Izziabby/Amp-lified/results/FET_OUTPUT.csv

#Digilent WaveForms Oscilloscope Acquisition
#Device Name: Discovery2NI
#Serial Number: SN:210321ABE20B
#Date Time: 2021-12-18 19:17:53.425
#Sample rate: 5e+06Hz
#Samples: 8192
#Trigger: Source: Channel 1 Type: Pulse Condition: Positive Level: 830 uV LCondition: Less Length: 500 ms Hyst.: 100 mV HoldOff: 100 ns
#Channel 1: Range: 1 V/div Offset: 0 div Attenuation: 1 X
#Channel 2: Range: 1 V/div Offset: -4.4 V Attenuation: 1 X
Time (s) | Channel 1 (V) | Channel 2 (V)
-0.000649902479338843 | -0.03114741341079754 | -0.02074836191465845
-0.000649702479338843 | -0.03488484549735023 | -0.02449063042452249
-0.000649502479338843 | -0.03488484549735023 | -0.02074836191466016
-0.000649302479338843 | -0.03488484549734853 | -0.02449063042452249
-0.0006491024793388431 | -0.03114741341079924 | -0.02449063042452249
-0.0006489024793388431 | -0.02740998132424655 | -0.02823289893438393
-0.0006487024793388431 | -0.02740998132424485 | -0.02449063042452249
-0.0006485024793388431 | -0.03114741341079754 | -0.02823289893438563
-0.000648302479338843 | -0.03114741341079754 | -0.02449063042452249
-0.000648102479338843 | -0.02740998132424485 | -0.02449063042452249
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
