Izziabby/Amp-lified/results/FET_OUTPUT_NO_I.csv

#Digilent WaveForms Oscilloscope Acquisition
#Device Name: Discovery2NI
#Serial Number: SN:210321ABE20B
#Date Time: 2021-12-18 19:20:11.627
#Sample rate: 8.33333e+06Hz
#Samples: 8192
#Trigger: Source: Channel 1 Type: Pulse Condition: Positive Level: 830 uV LCondition: Less Length: 500 ms Hyst.: 100 mV HoldOff: 100 ns
#Channel 1: Range: 1 V/div Offset: 0 div Attenuation: 1 X
#Channel 2: Range: 1 V/div Offset: -4.4 V Attenuation: 1 X
Time (s) | Channel 1 (V) | Channel 2 (V)
-0.0001980487359714862 | -0.3824660295467505 | 3.292613468573211
-0.0001979287359714862 | -0.3824660295467505 | 3.296355737083075
-0.0001978087359714861 | -0.3862034616333014 | 3.292613468573212
-0.0001976887359714862 | -0.3824660295467505 | 3.296355737083075
-0.0001975687359714861 | -0.3862034616333014 | 3.292613468573211
-0.0001974487359714862 | -0.3824660295467522 | 3.292613468573211
-0.0001973287359714862 | -0.3899408937198559 | 3.288871200063348
-0.0001972087359714862 | -0.3862034616333049 | 3.288871200063348
-0.0001970887359714862 | -0.3862034616333032 | 3.296355737083075
-0.0001969687359714861 | -0.3862034616333049 | 3.292613468573209
-0.0001968487359714862 | -0.3899408937198559 | 3.288871200063348
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
