Izziabby/Amp-lified/results/FET_OUTPUT_POWER.csv

#Digilent WaveForms Oscilloscope Acquisition
#Device Name: Discovery2NI
#Serial Number: SN:210321ABE20B
#Date Time: 2021-12-18 20:55:42.919
#Sample rate: 1.11111e+07Hz
#Samples: 8192
#Trigger: Source: Channel 1 Type: Pulse Condition: Positive Level: 3.34132 V LCondition: Less Length: 0 s Hyst.: 100 mV HoldOff: 100 ns
#Channel 1: Range: 1 V/div Offset: -3 div Attenuation: 1 X
#Channel 2: Range: 1 V/div Offset: -3 V Attenuation: 1 X
Time (s) | Channel 1 (V) | Channel 2 (V)
-0.000305189365493655 | 4.91639915425527 | -0.05045687713245931
-0.000305099365493655 | 4.920136586341822 | -0.04297234011273258
-0.0003050093654936549 | 4.916399154255275 | -0.04297234011272577
-0.0003049193654936549 | 4.920136586341824 | -0.04671460862258722
-0.0003048293654936549 | 4.923874018428378 | -0.05419914564231269
-0.0003047393654936549 | 4.912661722168727 | -0.0504568771324542
-0.0003046493654936549 | 4.920136586341822 | -0.0504568771324525
-0.0003045593654936549 | 4.916399154255275 | -0.0504568771324525
-0.0003044693654936549 | 4.920136586341826 | -0.0504568771324525
-0.0003043793654936549 | 4.916399154255274 | -0.04671460862258892
-0.0003042893654936549 | 4.923874018428379 | -0.03923007160286218
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
