Izziabby/Amp-lified/results/FPGA_OUTPUT_TEST.csv

#Digilent WaveForms Oscilloscope Acquisition
#Device Name: Discovery2NI
#Serial Number: SN:210321ABE20B
#Date Time: 2021-12-18 19:01:30.078
#Sample rate: 2.5e+07Hz
#Samples: 8192
#Trigger: Source: Channel 1 Type: Pulse Condition: Positive Level: 70 uV LCondition: Less Length: 500 ms Hyst.: 100 mV HoldOff: 100 ns
#Channel 1: Range: 1 V/div Offset: 0.3 div Attenuation: 1 X
#Channel 2: Range: 1 V/div Offset: -4 V Attenuation: 1 X
Time (s) | Channel 1 (V) | Channel 2 (V)
-0.0002539199519807923 | -0.03168648615037623 | 3.351035565472323
-0.0002538799519807923 | -0.02047418989072834 | 3.351035565472319
-0.0002538399519807923 | -0.03168648615037283 | 3.347293296962466
-0.0002537999519807923 | -0.02421162197727424 | 3.362262371001907
-0.0002537599519807923 | -0.02421162197727594 | 3.347293296962458
-0.0002537199519807923 | -0.03542391823692892 | 3.343551028452596
-0.0002536799519807923 | -0.03916135032347141 | 3.3435510284526
-0.0002536399519807923 | -0.02794905406382353 | 3.347293296962456
-0.0002535999519807923 | -0.02794905406382353 | 3.339808759942732
-0.0002535599519807923 | -0.02421162197727254 | 3.339808759942734
-0.0002535199519807923 | -0.02794905406382353 | 3.343551028452596
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
