Izziabby/Amp-lified/results/L_OUTPUT_REWIRED.csv

#Digilent WaveForms Oscilloscope Acquisition
#Device Name: Discovery2NI
#Serial Number: SN:210321ABE20B
#Date Time: 2021-12-18 19:34:19.647
#Sample rate: 3.44828e+06Hz
#Samples: 8192
#Trigger: Source: Channel 1 Type: Pulse Condition: Positive Level: -5.88 mV LCondition: Less Length: 500 ms Hyst.: 100 mV HoldOff: 100 ns
#Channel 1: Range: 50 mV/div Offset: 1.2 div Attenuation: 1 X
#Channel 2: Range: 200 mV/div Offset: -2.16 V Attenuation: 1 X
Time (s) | Channel 1 (V) | Channel 2 (V)
-0.000469162505800464 | -0.00359913086318951 | 1.725752729965397
-0.000468872505800464 | -0.003258818819657414 | 1.729156081236155
-0.000468582505800464 | -0.005300691080856806 | 1.731198091998612
-0.0004682925058004642 | -0.008023187429119772 | 1.735282113523519
-0.0004680025058004641 | -0.008363499472654036 | 1.735962783777672
-0.0004677125058004641 | -0.007342563342055116 | 1.732219097379839
-0.0004674225058004641 | -0.00462006699378921 | 1.729156081236155
-0.0004671325058004641 | -0.003258818819656485 | 1.727794740727851
-0.0004668425058004641 | -0.003258818819656485 | 1.728475410982003
-0.0004665525058004641 | -0.004960379037322389 | 1.73119809199861
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
