Izziabby/Amp-lified/tests/test_pwm.sv

`timescale 1ns / 1ps

module test_pwm;

parameter CLK_HZ = 12_000_000;
parameter CLK_PERIOD_NS = (1_000_000_000/CLK_HZ); // Approximation.
parameter PERIOD_US = 100; //us   // Keep it small in the testbench 
parameter CLK_TICKS = CLK_HZ/1_000_000*PERIOD_US;
parameter PWM_WIDTH = 4;

logic clk, rst, ena;
logic [$clog2(CLK_TICKS)-1:0] ticks;
wire pwm_step, pwm_out, pwm_not_out;

pulse_generator #(.N($clog2(CLK_TICKS))) PULSE_GEN (
  .clk(clk), .rst(rst), .ena(ena), .ticks(ticks),
  .out(pwm_step)
);

logic [PWM_WIDTH-1:0] duty;
pwm #(.N(PWM_WIDTH)) PWM(
  .clk(clk), .rst(rst), .ena(ena), .step(1'b1), .duty(duty), .out(pwm_out)
);

always #(CLK_PERIOD_NS/2) clk = ~clk;

initial begin
  $dumpfile("pwm.fst");
  $dumpvars(0, PULSE_GEN);
  $dumpvars(0, PWM);
  $dumpvars(0, NOTPWM);

  rst = 1;
  ena = 1;
  clk = 0;
  ticks = CLK_TICKS;
  $display("Enable the PWM %d ticks...", ticks);
  
  repeat (1) @(negedge clk);
  rst = 0;

  for(int i = 0; i < (2<<(PWM_WIDTH - 1)); i = i + 1) begin
    duty = i;
    repeat (2*(2<<PWM_WIDTH)*CLK_TICKS) @(posedge clk);
  end
  
  @(negedge clk);
  ena = 0;
  repeat (CLK_TICKS) @(posedge clk);
  $finish;
end

endmodule
