Izziabby/Amp-lified/(commit log)

2021-12-12 add not pwm signal
2021-12-17 working pwm A and B
2021-12-19 Circut Testing
    [FET_OUTPUT.csv, FET_OUTPUT_NO_I.csv, FET_OUTPUT_POWER.csv, FPGA_OUTPUT_TEST.csv, L_OUTPUT_REWIRED.csv]
